ot0tot/OpenOSD-X/doc/BreakoutboardBlockDiagram(Dec15,2025) .pdf

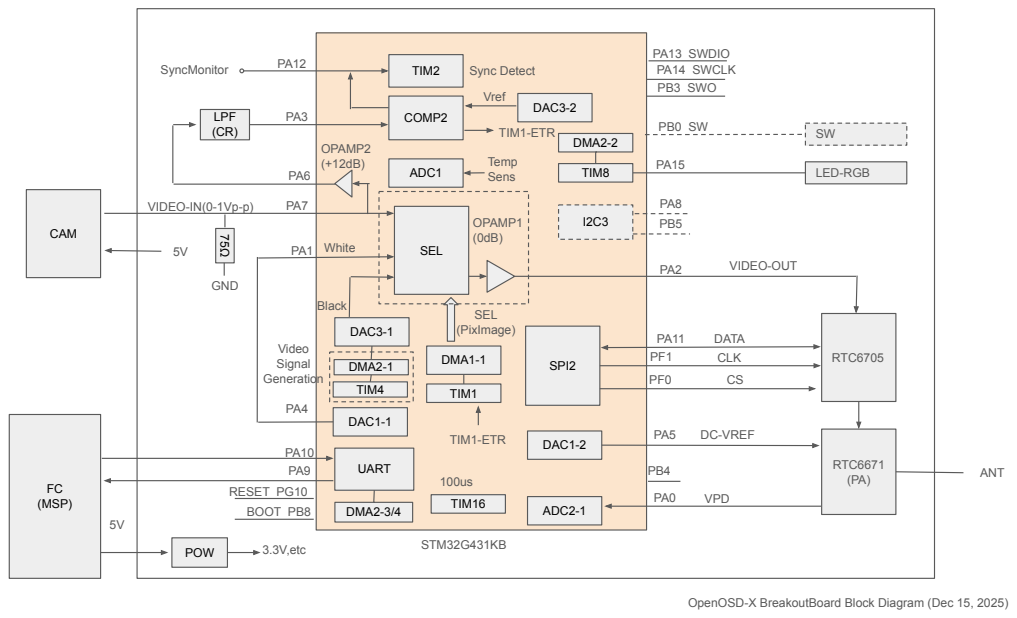
[picture p2: page 1]
COMP2; DAC3-2; Vref; TIM2; SEL; Sync Detect; DAC3-1; DMA1-1; TIM1; DAC1-1; SEL (PixImage); SyncMonitor; TIM4; Black; White; UART; DAC1-2; ADC2-1; SPI2; RTC6705; DATA; CLK; RTC6671 (PA); OPAMP1 (0dB); VIDEO-OUT; VIDEO-IN(0-1Vp-p); ANT; POW; CAM; STM32G431KB; FC (MSP); 3.3V,etc; VPD; DC-VREF; ADC1; PA13 SWDIO PA14 SWCLK; PB3 SWO; LED-RGB; RESET PG10; DMA2-1; Video Signal Generation; GND; LPF; OPAMP2 (+12dB); TIM1-ETR; TIM8; DMA2-2; BOOT PB8; TIM16; DMA2-3/4; Temp Sens

OpenOSD-X BreakoutBoard Block Diagram (Dec 15, 2025)

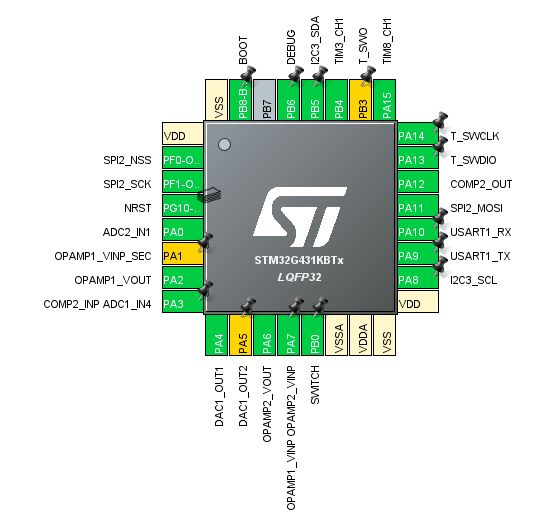
[picture p3: figure]

### NOTE

### Internal Oscillator Since the error is 1%, the rightmost character varies by about half a

character to the left and right, but this is acceptable.

### Input video signal

supports only 0–1 Vp-p.

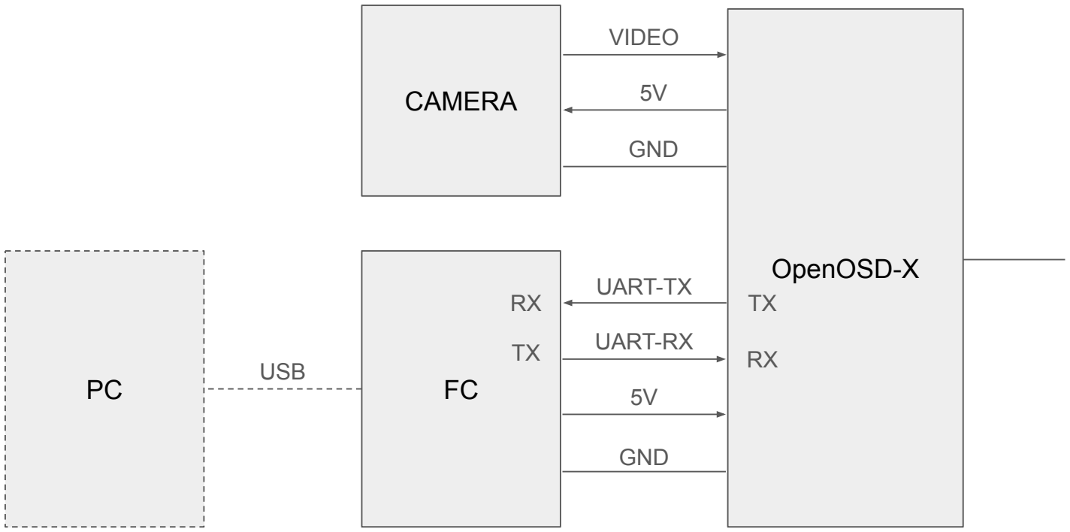
[picture p4: figure]
CAMERA; OpenOSD-X; VIDEO; GND; UART-TX; UART-RX; USB

## ANTENNA
