ot0tot/OpenOSD-X/doc/043_OpenOSD-X_REFERENCE.pdf

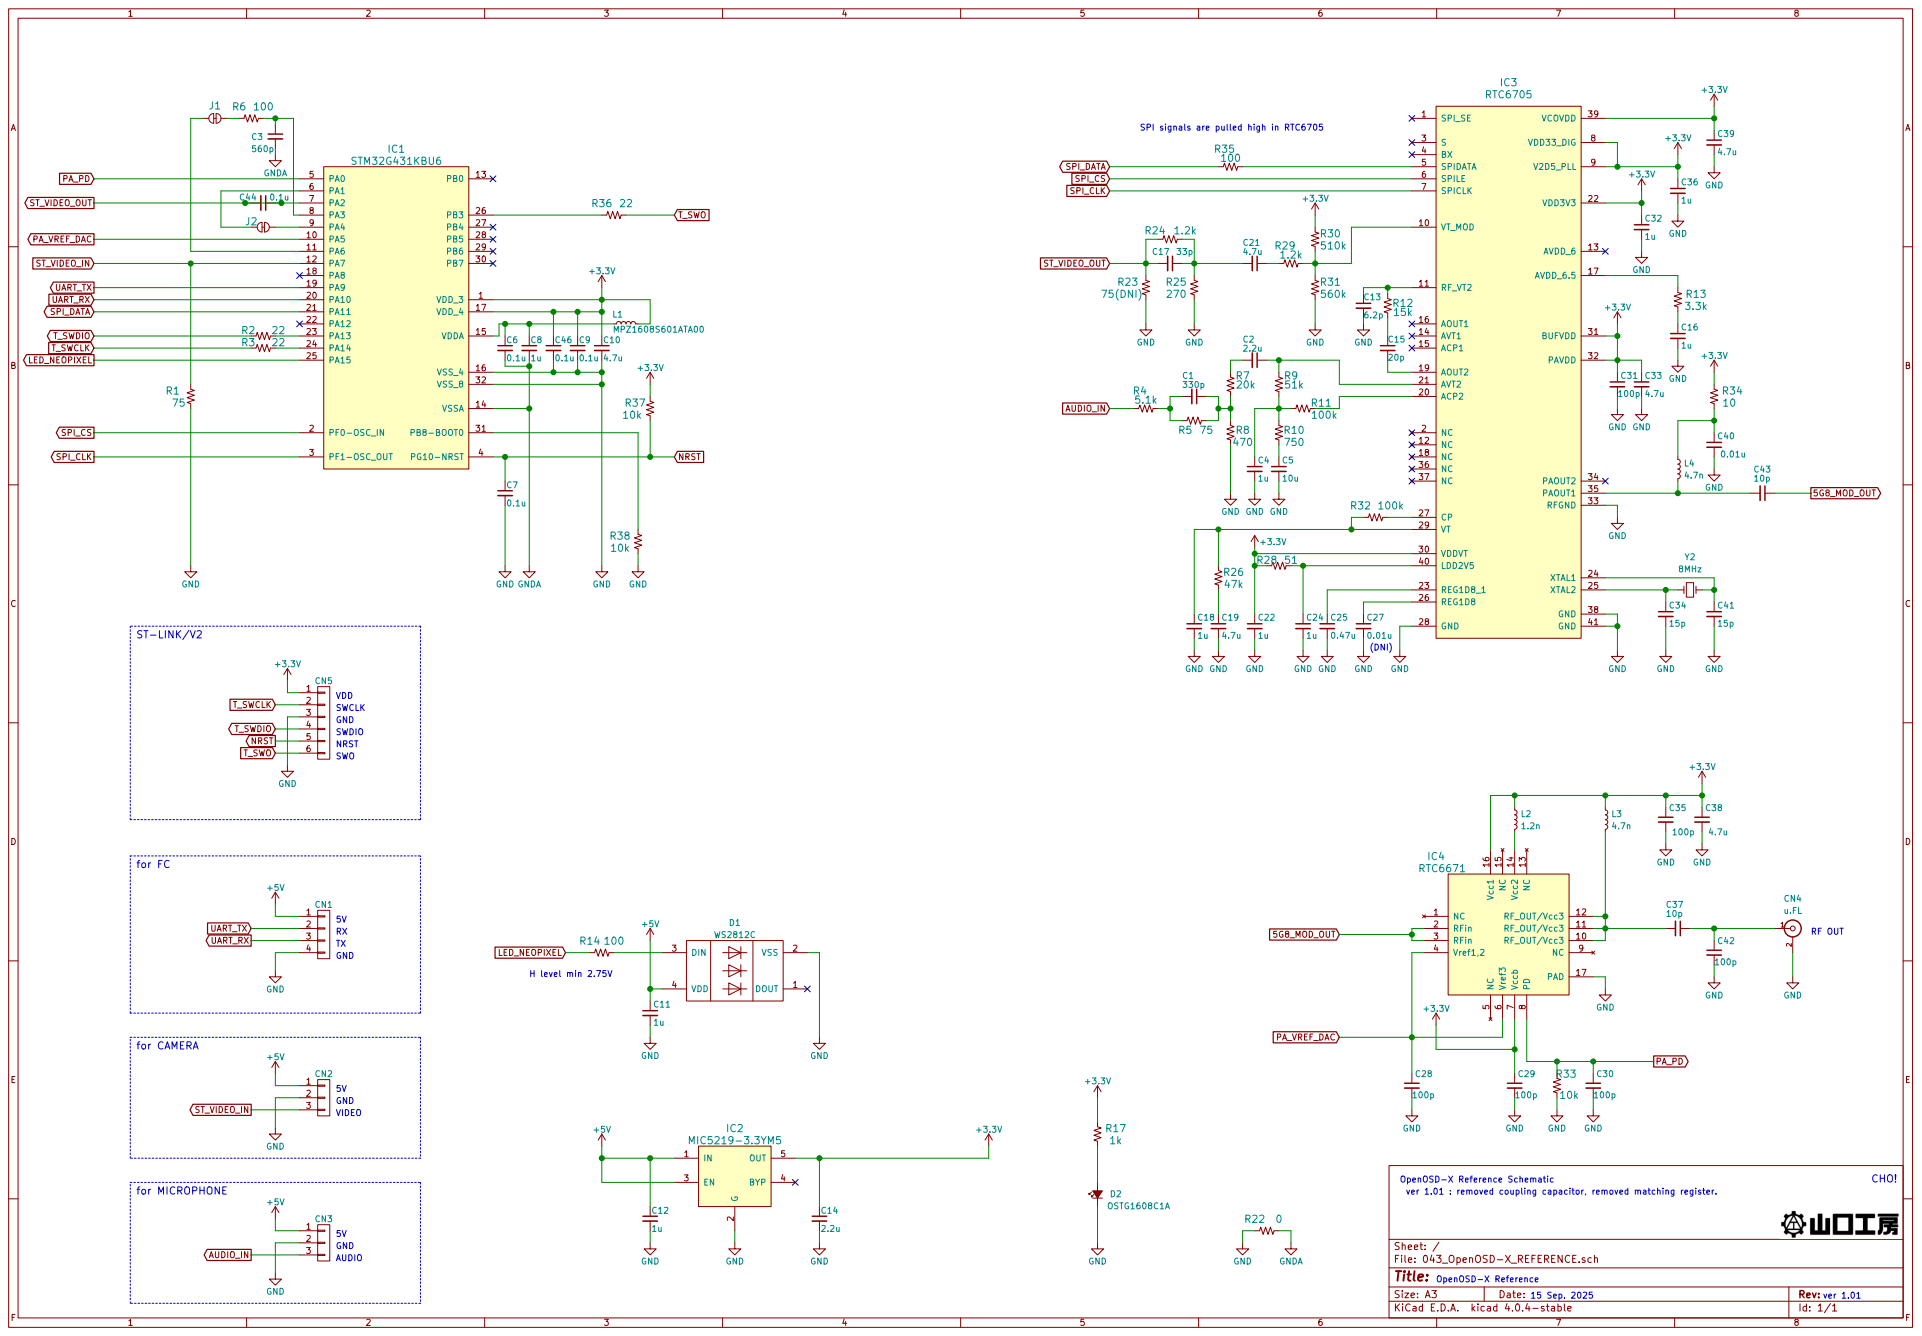
[picture p6: page 1]

SPI signals are pulled high in RTC6705

8 NC 9 RF_OUT/Vcc3 10 RF_OUT/Vcc3 11 RF_OUT/Vcc3 12 NC 13 Vcc2 14 NC 15 Vcc1 16 PAD 17

u.FL GND OpenOSD-X Reference

ver 1.01 : removed coupling capacitor, removed matching register.
