ot0tot/OpenOSD-X/Src/Core/Src/main.c

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
/* Includes ------------------------------------------------------------------*/
#include "stm32g4xx.h"

#include "main.h"
#include "sys_timer.h"
#include "msp.h"
#include "mspvtx.h"
#include "led.h"
#include "char_canvas.h"
#include "font.h"
#include "cli.h"
#include "log.h"
#include "rtc6705.h"
#include "vtx.h"
#include "temp.h"
#include "uart_dma.h"
#include "videosignal_gen.h"
#include "flash.h"
#include "setting.h"

/* USER CODE BEGIN PD */
#define TICKS_TO_HZ(ticks) ((170000000) / (ticks))
#define DEBUG_DAC2 0
#define DEBUG_VIDEO_STANDARD 0

#define SYNC_COUNT_5MS          148     // 5ms/32us = 156 count, 156count *0.95 = 148count
#define SYNC_LOST_CONSEC_MAX    10
#define SIGNAL_GEN_COUNT    1000/5  // signal lost detect time : 1sec

/* USER CODE END PD */

ADC_HandleTypeDef hadc1;
ADC_HandleTypeDef hadc2;

COMP_HandleTypeDef hcomp2;

DAC_HandleTypeDef hdac1;
DAC_HandleTypeDef hdac3;
DMA_HandleTypeDef hdma_dac3_ch1;

OPAMP_HandleTypeDef hopamp1;
OPAMP_HandleTypeDef hopamp2;

SPI_HandleTypeDef hspi2;

TIM_HandleTypeDef htim1;
TIM_HandleTypeDef htim2;
TIM_HandleTypeDef htim3;
TIM_HandleTypeDef htim4;
TIM_HandleTypeDef htim16;
DMA_HandleTypeDef hdma_tim1_up;
DMA_HandleTypeDef hdma_tim8_up;

UART_HandleTypeDef huart1;
DMA_HandleTypeDef hdma_usart1_rx;
DMA_HandleTypeDef hdma_usart1_tx;

void SystemClock_Config(void);
static void MX_GPIO_Init(void);
static void MX_DMA_Init(void);
static void MX_DAC1_Init(void);
static void MX_DAC3_Init(void);
static void MX_OPAMP1_Init(void);
static void MX_TIM1_Init(void);
static void MX_TIM2_Init(void);
static void MX_USART1_UART_Init(void);
static void MX_COMP2_Init(void);
static void MX_SPI2_Init(void);
static void MX_ADC2_Init(void);
static void MX_TIM3_Init(void);
static void MX_OPAMP2_Init(void);
static void MX_ADC1_Init(void);
static void MX_TIM4_Init(void);
static void MX_TIM16_Init(void);
/* USER CODE BEGIN PFP */


#define VIDEO_FORMAT_STR    ((setting()->videoFormat == VIDEO_PAL) ? "PAL" : "NTSC")

typedef enum {
    FRAME_UNKNOWN=0,
    FRAME_EVEN,
    FRAME_ODD,
}FRAME_ODD_EVEN;


typedef enum {
    STATE_LOST = 0,
    STATE_TUNE_PULSE_LEVEL_LOW,
    STATE_TUNE_PULSE_LEVEL_HIGH,
    STATE_VSYNC_WAIT,
    STATE_SYNC,
    STATE_DISABLE,
}STATE;
STATE state = STATE_LOST;

char *state_str[] = {
    "STATE_LOST",
    "STATE_TUNE_PULSE_LEVEL_LOW",
    "STATE_TUNE_PULSE_LEVEL_HIGH",
    "STATE_VSYNC_WAIT",
    "STATE_SYNC",
    "STATE_DISABLE",
};

int32_t canvas_v_offset[]  ={CANVAS_V_OFFSET_NTSC, CANVAS_V_OFFSET_PAL};
int32_t canvas_v[]         ={CANVAS_V_NTSC, CANVAS_V_PAL};

static uint16_t pluse_level_low = 1000;
static uint16_t pluse_level_high = 0;
static uint16_t state_lost_count = 0;

static bool osd_ebable = true;


__attribute__((section (".sram2")))
uint32_t font2selTable[256][4] = {
    {BLK, BLK, BLK, BLK}, {BLK, BLK, BLK, TRS}, {BLK, BLK, BLK, WHI}, {BLK, BLK, BLK, TRS}, {BLK, BLK, TRS, BLK}, {BLK, BLK, TRS, TRS}, {BLK, BLK, TRS, WHI}, {BLK, BLK, TRS, TRS}, // 0x00
    {BLK, BLK, WHI, BLK}, {BLK, BLK, WHI, TRS}, {BLK, BLK, WHI, WHI}, {BLK, BLK, WHI, TRS}, {BLK, BLK, TRS, BLK}, {BLK, BLK, TRS, TRS}, {BLK, BLK, TRS, WHI}, {BLK, BLK, TRS, TRS}, // 0x08
    {BLK, TRS, BLK, BLK}, {BLK, TRS, BLK, TRS}, {BLK, TRS, BLK, WHI}, {BLK, TRS, BLK, TRS}, {BLK, TRS, TRS, BLK}, {BLK, TRS, TRS, TRS}, {BLK, TRS, TRS, WHI}, {BLK, TRS, TRS, TRS}, // 0x10
    {BLK, TRS, WHI, BLK}, {BLK, TRS, WHI, TRS}, {BLK, TRS, WHI, WHI}, {BLK, TRS, WHI, TRS}, {BLK, TRS, TRS, BLK}, {BLK, TRS, TRS, TRS}, {BLK, TRS, TRS, WHI}, {BLK, TRS, TRS, TRS}, // 0x18
    {BLK, WHI, BLK, BLK}, {BLK, WHI, BLK, TRS}, {BLK, WHI, BLK, WHI}, {BLK, WHI, BLK, TRS}, {BLK, WHI, TRS, BLK}, {BLK, WHI, TRS, TRS}, {BLK, WHI, TRS, WHI}, {BLK, WHI, TRS, TRS}, // 0x20
    {BLK, WHI, WHI, BLK}, {BLK, WHI, WHI, TRS}, {BLK, WHI, WHI, WHI}, {BLK, WHI, WHI, TRS}, {BLK, WHI, TRS, BLK}, {BLK, WHI, TRS, TRS}, {BLK, WHI, TRS, WHI}, {BLK, WHI, TRS, TRS}, // 0x28
    {BLK, TRS, BLK, BLK}, {BLK, TRS, BLK, TRS}, {BLK, TRS, BLK, WHI}, {BLK, TRS, BLK, TRS}, {BLK, TRS, TRS, BLK}, {BLK, TRS, TRS, TRS}, {BLK, TRS, TRS, WHI}, {BLK, TRS, TRS, TRS}, // 0x30
    {BLK, TRS, WHI, BLK}, {BLK, TRS, WHI, TRS}, {BLK, TRS, WHI, WHI}, {BLK, TRS, WHI, TRS}, {BLK, TRS, TRS, BLK}, {BLK, TRS, TRS, TRS}, {BLK, TRS, TRS, WHI}, {BLK, TRS, TRS, TRS}, // 0x38
    {TRS, BLK, BLK, BLK}, {TRS, BLK, BLK, TRS}, {TRS, BLK, BLK, WHI}, {TRS, BLK, BLK, TRS}, {TRS, BLK, TRS, BLK}, {TRS, BLK, TRS, TRS}, {TRS, BLK, TRS, WHI}, {TRS, BLK, TRS, TRS}, // 0x40
    {TRS, BLK, WHI, BLK}, {TRS, BLK, WHI, TRS}, {TRS, BLK, WHI, WHI}, {TRS, BLK, WHI, TRS}, {TRS, BLK, TRS, BLK}, {TRS, BLK, TRS, TRS}, {TRS, BLK, TRS, WHI}, {TRS, BLK, TRS, TRS}, // 0x48
    {TRS, TRS, BLK, BLK}, {TRS, TRS, BLK, TRS}, {TRS, TRS, BLK, WHI}, {TRS, TRS, BLK, TRS}, {TRS, TRS, TRS, BLK}, {TRS, TRS, TRS, TRS}, {TRS, TRS, TRS, WHI}, {TRS, TRS, TRS, TRS}, // 0x50
    {TRS, TRS, WHI, BLK}, {TRS, TRS, WHI, TRS}, {TRS, TRS, WHI, WHI}, {TRS, TRS, WHI, TRS}, {TRS, TRS, TRS, BLK}, {TRS, TRS, TRS, TRS}, {TRS, TRS, TRS, WHI}, {TRS, TRS, TRS, TRS}, // 0x58
    {TRS, WHI, BLK, BLK}, {TRS, WHI, BLK, TRS}, {TRS, WHI, BLK, WHI}, {TRS, WHI, BLK, TRS}, {TRS, WHI, TRS, BLK}, {TRS, WHI, TRS, TRS}, {TRS, WHI, TRS, WHI}, {TRS, WHI, TRS, TRS}, // 0x60
    {TRS, WHI, WHI, BLK}, {TRS, WHI, WHI, TRS}, {TRS, WHI, WHI, WHI}, {TRS, WHI, WHI, TRS}, {TRS, WHI, TRS, BLK}, {TRS, WHI, TRS, TRS}, {TRS, WHI, TRS, WHI}, {TRS, WHI, TRS, TRS}, // 0x68
    {TRS, TRS, BLK, BLK}, {TRS, TRS, BLK, TRS}, {TRS, TRS, BLK, WHI}, {TRS, TRS, BLK, TRS}, {TRS, TRS, TRS, BLK}, {TRS, TRS, TRS, TRS}, {TRS, TRS, TRS, WHI}, {TRS, TRS, TRS, TRS}, // 0x70
    {TRS, TRS, WHI, BLK}, {TRS, TRS, WHI, TRS}, {TRS, TRS, WHI, WHI}, {TRS, TRS, WHI, TRS}, {TRS, TRS, TRS, BLK}, {TRS, TRS, TRS, TRS}, {TRS, TRS, TRS, WHI}, {TRS, TRS, TRS, TRS}, // 0x78
    {WHI, BLK, BLK, BLK}, {WHI, BLK, BLK, TRS}, {WHI, BLK, BLK, WHI}, {WHI, BLK, BLK, TRS}, {WHI, BLK, TRS, BLK}, {WHI, BLK, TRS, TRS}, {WHI, BLK, TRS, WHI}, {WHI, BLK, TRS, TRS}, // 0x80
    {WHI, BLK, WHI, BLK}, {WHI, BLK, WHI, TRS}, {WHI, BLK, WHI, WHI}, {WHI, BLK, WHI, TRS}, {WHI, BLK, TRS, BLK}, {WHI, BLK, TRS, TRS}, {WHI, BLK, TRS, WHI}, {WHI, BLK, TRS, TRS}, // 0x88
    {WHI, TRS, BLK, BLK}, {WHI, TRS, BLK, TRS}, {WHI, TRS, BLK, WHI}, {WHI, TRS, BLK, TRS}, {WHI, TRS, TRS, BLK}, {WHI, TRS, TRS, TRS}, {WHI, TRS, TRS, WHI}, {WHI, TRS, TRS, TRS}, // 0x90
    {WHI, TRS, WHI, BLK}, {WHI, TRS, WHI, TRS}, {WHI, TRS, WHI, WHI}, {WHI, TRS, WHI, TRS}, {WHI, TRS, TRS, BLK}, {WHI, TRS, TRS, TRS}, {WHI, TRS, TRS, WHI}, {WHI, TRS, TRS, TRS}, // 0x98
    {WHI, WHI, BLK, BLK}, {WHI, WHI, BLK, TRS}, {WHI, WHI, BLK, WHI}, {WHI, WHI, BLK, TRS}, {WHI, WHI, TRS, BLK}, {WHI, WHI, TRS, TRS}, {WHI, WHI, TRS, WHI}, {WHI, WHI, TRS, TRS}, // 0xa0
    {WHI, WHI, WHI, BLK}, {WHI, WHI, WHI, TRS}, {WHI, WHI, WHI, WHI}, {WHI, WHI, WHI, TRS}, {WHI, WHI, TRS, BLK}, {WHI, WHI, TRS, TRS}, {WHI, WHI, TRS, WHI}, {WHI, WHI, TRS, TRS}, // 0xa8
    {WHI, TRS, BLK, BLK}, {WHI, TRS, BLK, TRS}, {WHI, TRS, BLK, WHI}, {WHI, TRS, BLK, TRS}, {WHI, TRS, TRS, BLK}, {WHI, TRS, TRS, TRS}, {WHI, TRS, TRS, WHI}, {WHI, TRS, TRS, TRS}, // 0xb0
    {WHI, TRS, WHI, BLK}, {WHI, TRS, WHI, TRS}, {WHI, TRS, WHI, WHI}, {WHI, TRS, WHI, TRS}, {WHI, TRS, TRS, BLK}, {WHI, TRS, TRS, TRS}, {WHI, TRS, TRS, WHI}, {WHI, TRS, TRS, TRS}, // 0xb8
    {TRS, BLK, BLK, BLK}, {TRS, BLK, BLK, TRS}, {TRS, BLK, BLK, WHI}, {TRS, BLK, BLK, TRS}, {TRS, BLK, TRS, BLK}, {TRS, BLK, TRS, TRS}, {TRS, BLK, TRS, WHI}, {TRS, BLK, TRS, TRS}, // 0xc0
    {TRS, BLK, WHI, BLK}, {TRS, BLK, WHI, TRS}, {TRS, BLK, WHI, WHI}, {TRS, BLK, WHI, TRS}, {TRS, BLK, TRS, BLK}, {TRS, BLK, TRS, TRS}, {TRS, BLK, TRS, WHI}, {TRS, BLK, TRS, TRS}, // 0xc8
    {TRS, TRS, BLK, BLK}, {TRS, TRS, BLK, TRS}, {TRS, TRS, BLK, WHI}, {TRS, TRS, BLK, TRS}, {TRS, TRS, TRS, BLK}, {TRS, TRS, TRS, TRS}, {TRS, TRS, TRS, WHI}, {TRS, TRS, TRS, TRS}, // 0xd0
    {TRS, TRS, WHI, BLK}, {TRS, TRS, WHI, TRS}, {TRS, TRS, WHI, WHI}, {TRS, TRS, WHI, TRS}, {TRS, TRS, TRS, BLK}, {TRS, TRS, TRS, TRS}, {TRS, TRS, TRS, WHI}, {TRS, TRS, TRS, TRS}, // 0xd8
    {TRS, WHI, BLK, BLK}, {TRS, WHI, BLK, TRS}, {TRS, WHI, BLK, WHI}, {TRS, WHI, BLK, TRS}, {TRS, WHI, TRS, BLK}, {TRS, WHI, TRS, TRS}, {TRS, WHI, TRS, WHI}, {TRS, WHI, TRS, TRS}, // 0xe0
    {TRS, WHI, WHI, BLK}, {TRS, WHI, WHI, TRS}, {TRS, WHI, WHI, WHI}, {TRS, WHI, WHI, TRS}, {TRS, WHI, TRS, BLK}, {TRS, WHI, TRS, TRS}, {TRS, WHI, TRS, WHI}, {TRS, WHI, TRS, TRS}, // 0xe8
    {TRS, TRS, BLK, BLK}, {TRS, TRS, BLK, TRS}, {TRS, TRS, BLK, WHI}, {TRS, TRS, BLK, TRS}, {TRS, TRS, TRS, BLK}, {TRS, TRS, TRS, TRS}, {TRS, TRS, TRS, WHI}, {TRS, TRS, TRS, TRS}, // 0xf0
    {TRS, TRS, WHI, BLK}, {TRS, TRS, WHI, TRS}, {TRS, TRS, WHI, WHI}, {TRS, TRS, WHI, TRS}, {TRS, TRS, TRS, BLK}, {TRS, TRS, TRS, TRS}, {TRS, TRS, TRS, WHI}, {TRS, TRS, TRS, TRS}  // 0xf8
};




//uint32_t dataBuffer[2][512] __attribute__((aligned(4))) = {0};
uint32_t dataBuffer[2][CANVAS_H+16] __attribute__((aligned(4))) = {0};

void osd_dma(DETECT_SYNC detect_sync);
void sync_detect(DETECT_SYNC detect_sync);
/* USER CODE END PFP */


/* USER CODE BEGIN 0 */
void rebootDfu(void)
{
    LL_APB1_GRP1_EnableClock(LL_APB1_GRP1_PERIPH_PWR);
    LL_PWR_EnableBkUpAccess();
    LL_APB1_GRP1_EnableClock(LL_APB1_GRP1_PERIPH_RTCAPB);
    LL_RCC_EnableRTC();
    TAMP->BKP0R = BOOTLOADER_DFU_MAGIC;
    __disable_irq(); 
    NVIC_SystemReset();
}

int __io_putchar(uint8_t ch) {
    return ITM_SendChar(ch);
}

void osd_enable(uint8_t en)
{
    if (en){
        state = STATE_LOST;
        state_lost_count = 0;
    }else{
        state = STATE_DISABLE;
        videosignal_gen_stop();
    }
}

__attribute__((section (".ccmram_code"), optimize("O2")))
void SetLine(register volatile uint32_t *data, register volatile uint8_t *buf, int line)
{
    register volatile uint32_t *fp;
    int linex = line*3;
    for(int ch=0; ch<COLUMN_SIZE; ch++){
        register volatile  uint8_t *fontp = (uint8_t*)&font[*buf++][linex];
        fp = font2selTable[ *fontp ];
        *data++ = *fp++;
        *data++ = *fp++;
        *data++ = *fp++;
        *data++ = *fp++;
        fp = font2selTable[ *(fontp+1) ];
        *data++ = *fp++;
        *data++ = *fp++;
        *data++ = *fp++;
        *data++ = *fp++;
        fp = font2selTable[ *(fontp+2) ];
        *data++ = *fp++;
        *data++ = *fp++;
        *data++ = *fp++;
        *data++ = *fp++;
    }
    *data++ = TRS;      // end
    return;
}

__attribute__((section (".ccmram_code"), optimize("O2")))
void intHsyncFallEdge(void)
{
//    HAL_GPIO_WritePin(DEBUG_GPIO_Port, DEBUG_Pin, GPIO_PIN_SET);

    if (state != STATE_DISABLE){
        volatile uint32_t uwIC1Value = TIM2->CCR1;      // down to down edge
        volatile uint32_t uwIC2Value = TIM2->CCR2;      // down to up edge;

        DETECT_SYNC detect_sync = DETECT_UNKNOWN;

        #define HSYNC_PERIOD_MIN (572*17)   // 63.5*0.9  ntsc:63.5
        #define HSYNC_PERIOD_MAX (704*17)   // 64.0*1.1  pal:64.0
        #define HSYNC_PULSE_MIN (44*17)
        #define HSYNC_PULSE_MAX (50*17)
        #define VSYNC_PULSE_MIN (244*17)
        #define VSYNC_PULSE_MAX (298*17)
        #define EQUIVALENT_PULSE_MIN    (20*17)
        #define EQUIVALENT_PULSE_MAX    (26*17)

        if (    uwIC1Value > HSYNC_PERIOD_MIN && uwIC1Value < HSYNC_PERIOD_MAX &&
                uwIC2Value > HSYNC_PULSE_MIN && uwIC2Value < HSYNC_PULSE_MAX ){
                    detect_sync = DETECT_HSYNC;
        } else if ( uwIC1Value > HSYNC_PERIOD_MIN/2 && uwIC1Value < HSYNC_PERIOD_MAX/2 &&
                    uwIC2Value > EQUIVALENT_PULSE_MIN && uwIC2Value < EQUIVALENT_PULSE_MAX ){
                        detect_sync = DETECT_EQUIVALENT;
        }else if (  uwIC1Value > HSYNC_PERIOD_MIN/2 && uwIC1Value < HSYNC_PERIOD_MAX/2 &&
                    uwIC2Value > VSYNC_PULSE_MIN && uwIC2Value < VSYNC_PULSE_MAX ){
                        detect_sync = DETECT_VSYNC;
        }

        osd_dma(detect_sync);
        sync_detect(detect_sync);
    }

//    HAL_GPIO_WritePin(DEBUG_GPIO_Port, DEBUG_Pin, GPIO_PIN_RESET);
}

uint32_t sync_count = 0;                // for detect sync lost
uint16_t sync_lost_consec = 0;
int32_t equivalent_pulse_count = 0;     // ntsc:odd=6,odd=5
int32_t video_line = 0;
int32_t video_line_last = 0;
FRAME_ODD_EVEN  frame_odd_even = FRAME_UNKNOWN;
__attribute__((section (".ccmram_code"), optimize("O2")))
void sync_detect(DETECT_SYNC detect_sync)
{
    switch(detect_sync){
        case DETECT_HSYNC:
            if (frame_odd_even == FRAME_UNKNOWN){
                if (equivalent_pulse_count & 0x1){
                    if (setting()->videoFormat == VIDEO_NTSC){
                        frame_odd_even = FRAME_ODD;
                        video_line = 1;
                    }else{
                        frame_odd_even = FRAME_EVEN;
                        video_line = 0;
                    }
                }else{
                    if (setting()->videoFormat == VIDEO_NTSC){
                        frame_odd_even = FRAME_EVEN;
                        video_line = 0;
                    }else{
                        frame_odd_even = FRAME_ODD;
                        video_line = 1;
                    }
                }
            }else{
                video_line += 2;
            }
            sync_count += 2;
            break;
        case DETECT_VSYNC:
            sync_count++;
            switch(state){
                case STATE_VSYNC_WAIT:
                    state = STATE_SYNC;
                    break;
                case STATE_SYNC:
                    if (video_line > 0){
                        video_line_last = video_line;
                    }
                    video_line = 0;
                    break;
                default:
                    break;
            }
            equivalent_pulse_count = 0;
            frame_odd_even = FRAME_UNKNOWN;
            break;
        case DETECT_EQUIVALENT:
            equivalent_pulse_count++;
            sync_count++;
            break;
        case DETECT_UNKNOWN:
            break;
    }
}

__attribute__((section (".ccmram_code"), optimize("O2")))
void osd_dma(DETECT_SYNC detect_sync)
{
// static uint32_t vcanvas_count = 0;

    if (detect_sync != DETECT_HSYNC){
        //vcanvas_count = 0;
        return;
    }
    if (!osd_ebable){
        return;
    }
    if (state != STATE_SYNC){
        return;
    }
    if ( video_line == 0 ){
        charCanvasNext();
    }

    int32_t canvas_line = video_line - canvas_v_offset[setting()->videoFormat];

    if ( canvas_line >= 0 && canvas_line < canvas_v[setting()->videoFormat] ){

        // 1. Stop TIM1
        TIM1->CR1 &= ~TIM_CR1_CEN;

        // 2. Disable DMA channel
        DMA1_Channel1->CCR &= ~DMA_CCR_EN;

        // 3. Clear TIM1 update flag
        TIM1->SR &= ~TIM_SR_UIF;

        // 4. Disable TIM1 DMA
        TIM1->DIER &= ~TIM_DIER_UDE;

        // 5. Reset TIM1 counter
        TIM1->CNT = 0;

        // 6. Configure DMA transfer: Mem-to-Periph, High priority, no increment on peripheral, increment memory, 32-bit
        DMA1_Channel1->CCR = DMA_CCR_DIR       // Memory to peripheral
                           | DMA_CCR_PL_1      // High priority
                           | DMA_CCR_MINC      // Memory increment
                           | DMA_CCR_MSIZE_1   // Memory size: word
                           | DMA_CCR_PSIZE_1;  // Peripheral size: word

        // 7. Set DMA addresses: source = dataBuffer, destination = OPAMP1->CSR
        DMA1_Channel1->CPAR = (uint32_t)&OPAMP1->CSR;
        DMA1_Channel1->CMAR = (uint32_t)&dataBuffer[(canvas_line>>1) & 0x1];
        // 8. Set number of words to transfer
        DMA1_Channel1->CNDTR = CANVAS_H + 1;

        // 9. Enable DMA channel
        DMA1_Channel1->CCR |= DMA_CCR_EN;

        // 10. Enable DMA request on TIM1 update event
        TIM1->DIER |= TIM_DIER_UDE;

        // 11. Start TIM1
        TIM1->CR1 |= TIM_CR1_CEN;

        // 12. Advance canvas line counter
        //vcanvas_count++;
    }

    int next_line = canvas_line + 2;

    if ( next_line >= 0 && next_line < canvas_v[setting()->videoFormat] ){
        #ifdef RESOLUTION_HD
            SetLine(&dataBuffer[(next_line>>1) & 0x1][CANVAS_H_OFFSET], (uint8_t*)charCanvasGet(next_line/18), next_line % 18);
        #else
            SetLine(&dataBuffer[(next_line>>1) & 0x1][CANVAS_H_OFFSET], (uint8_t*)charCanvasGet((next_line>>1)/18), (next_line>>1) % 18);
        #endif
    }

}



void sync_proc(void)
{
 static uint32_t state_time = 0;

    uint32_t now = HAL_GetTick();
    if(now - state_time < 5){
        return;
    }
    state_time += 5;

    switch(state){
        case STATE_LOST:
            if (sync_count >= SYNC_COUNT_5MS){
                // sync detect
                videosignal_gen_stop();
                pluse_level_high = pluse_level_low +50;
                pluse_level_low -= 50;
                HAL_DAC_SetValue(&hdac3, DAC_CHANNEL_2, DAC_ALIGN_12B_R, (0xfff*pluse_level_low)/3300);
                state = STATE_TUNE_PULSE_LEVEL_LOW;
                DEBUG_PRINTF("state:STATE_TUNE_PULSE_LEVEL_LOW");
            }else{
                state_lost_count = (state_lost_count < SIGNAL_GEN_COUNT) ? state_lost_count+1 : state_lost_count;
                if (state_lost_count == SIGNAL_GEN_COUNT){
                    state_lost_count = 0xffff;
                    videosignal_gen_start();
                }
                pluse_level_low = (pluse_level_low + 250) % (2500);
                pluse_level_low = (pluse_level_low == 0) ? 250 : pluse_level_low;
                HAL_DAC_SetValue(&hdac3, DAC_CHANNEL_2, DAC_ALIGN_12B_R, (0xfff*pluse_level_low)/3300);
            }
            break;
        case STATE_TUNE_PULSE_LEVEL_LOW:
            if (sync_count < SYNC_COUNT_5MS || pluse_level_low == 0){    // min 0mv
                state = STATE_TUNE_PULSE_LEVEL_HIGH;
                DEBUG_PRINTF("state:STATE_TUNE_PULSE_LEVEL_HIGH");
                HAL_DAC_SetValue(&hdac3, DAC_CHANNEL_2, DAC_ALIGN_12B_R, (0xfff*pluse_level_high)/3300);
            }else{
                pluse_level_low -= 50;
                HAL_DAC_SetValue(&hdac3, DAC_CHANNEL_2, DAC_ALIGN_12B_R, (0xfff*pluse_level_low)/3300);
            }
            break;
        case STATE_TUNE_PULSE_LEVEL_HIGH:
            if (sync_count < SYNC_COUNT_5MS || pluse_level_high == 2500){    // max2500mv
                state = STATE_VSYNC_WAIT;
                DEBUG_PRINTF("state:STATE_VSYNC_WAIT)");
                HAL_DAC_SetValue(&hdac3, DAC_CHANNEL_2, DAC_ALIGN_12B_R, (0xfff * ((pluse_level_high + pluse_level_low)/2))/3300);
                HAL_DAC_SetValue(&hdac3, DAC_CHANNEL_1, DAC_ALIGN_12B_R, (0xfff * ((pluse_level_high/4) + 100)/3300));    // black level -12dB=1/4 +50mv       todo: auto level tune
            }else{
                pluse_level_high += 50;
                HAL_DAC_SetValue(&hdac3, DAC_CHANNEL_2, DAC_ALIGN_12B_R, (0xfff*pluse_level_high)/3300);
            }
            break;
        case STATE_VSYNC_WAIT:
        case STATE_SYNC:
            if (sync_count < SYNC_COUNT_5MS){
                if ( ++sync_lost_consec > SYNC_LOST_CONSEC_MAX){
                    DEBUG_PRINTF("state:STATE_LOST)");
                    state = STATE_LOST;
                    pluse_level_low = 1000;
                    state_lost_count = 0;
                }
            }else{
                sync_lost_consec = 0;
            }
            if (video_line_last != 0){;
                if (video_line > 500 && video_line_last < 510) {        // NTSC (262-10)*2= 504
                    setting()->videoFormat = VIDEO_NTSC;     // ntsc
                } else if (video_line > 600 && video_line < 620) {
                    setting()->videoFormat = VIDEO_PAL;     // pal
                }
            }
            break;
        case STATE_DISABLE:
            HAL_DAC_SetValue(&hdac3, DAC_CHANNEL_2, DAC_ALIGN_12B_R, (0xfff*pluse_level_high)/3300);
            break;
    }
    sync_count = 0;
}



__attribute__((section (".ccmram_code"), optimize("O2")))
bool writeFlashFont(uint16_t addr, uint8_t *data)
{
    enableOSD(false);

    HAL_FLASH_Unlock();
    __HAL_FLASH_CLEAR_FLAG(FLASH_FLAG_OPTVERR);
    if ( (addr & 0x1f) == 0 ){
        // erase
        uint32_t erase_addr = (uint32_t)&font[addr][0];
        DEBUG_PRINTF("erase start 0x%x", erase_addr);
        static FLASH_EraseInitTypeDef EraseInitStruct;
        EraseInitStruct.TypeErase   = FLASH_TYPEERASE_PAGES;
        EraseInitStruct.Page        = GET_FLASH_PAGE(erase_addr);
        EraseInitStruct.NbPages     = 1;
        uint32_t PageError = 0;
        if (HAL_FLASHEx_Erase(&EraseInitStruct, &PageError) != HAL_OK){
            ;
        }
        DEBUG_PRINTF("erase end");
    }
    // write
    for(int x=0; x<FONT_SIZE; x+=8){
        uint64_t wdata = *data++;
        wdata += (uint64_t)(*data++)<<8;
        wdata += (uint64_t)(*data++)<<16;
        wdata += (uint64_t)(*data++)<<24;
        wdata += (uint64_t)(*data++)<<32;
        wdata += (uint64_t)(*data++)<<40;
        wdata += (uint64_t)(*data++)<<48;
        wdata += (uint64_t)(*data++)<<56;

        if (HAL_FLASH_Program(FLASH_TYPEPROGRAM_DOUBLEWORD, (uint32_t)&font[addr][x], wdata) == HAL_OK){
        }
    }
    HAL_FLASH_Lock();

    return true;
}
void enableOSD(bool en)
{
    osd_ebable = en;
}




/* USER CODE END 0 */

/**
  * @brief  The application entry point.
  * @retval int
  */
int main(void)
{

  /* USER CODE BEGIN 1 */ 
    DEBUG_INIT();
    DEBUG_PRINTF("Start");
  /* USER CODE END 1 */

  /* MCU Configuration--------------------------------------------------------*/

  /* Reset of all peripherals, Initializes the Flash interface and the Systick. */
  HAL_Init();

  /* Configure the system clock */
  SystemClock_Config();

  /* Initialize all configured peripherals */
  MX_GPIO_Init();
  MX_DMA_Init();
  MX_DAC1_Init();
  MX_DAC3_Init();
  MX_OPAMP1_Init();
  MX_TIM1_Init();
  MX_TIM2_Init();
  MX_USART1_UART_Init();
  MX_COMP2_Init();
  MX_SPI2_Init();
  MX_ADC2_Init();
  MX_TIM3_Init();
  MX_OPAMP2_Init();
  MX_ADC1_Init();
  MX_TIM4_Init();
  MX_TIM16_Init();
  /* USER CODE BEGIN 2 */

    HAL_TIM_Base_MspInit(&htim16);
    initSysTimer();

    for (int x=0; x<CANVAS_H_OFFSET; x++){
        dataBuffer[0][x] = TRS;
        dataBuffer[1][x] = TRS;
    }
    charCanvasInit();


    HAL_COMP_MspInit(&hcomp2);
    HAL_COMP_Start(&hcomp2);

    HAL_OPAMP_MspInit(&hopamp1);
    HAL_OPAMP_Start(&hopamp1);
    OPAMP1->CSR = TRS;

    HAL_OPAMP_MspInit(&hopamp2);
    HAL_OPAMP_Start(&hopamp2);

    HAL_DAC_Init(&hdac1);
    HAL_DAC_MspInit(&hdac1);
    HAL_DAC_Start(&hdac1, DAC_CHANNEL_1);
    HAL_DAC_SetValue(&hdac1, DAC_CHANNEL_1, DAC_ALIGN_12B_R, (0xfff*1500)/3300);    // WHITE:1.5v (Foxeer OSD is 1.5V)

    HAL_DAC_Init(&hdac3);
    HAL_DAC_MspInit(&hdac3);
    HAL_DAC_Start(&hdac3, DAC_CHANNEL_1);
    HAL_DAC_SetValue(&hdac3, DAC_CHANNEL_1, DAC_ALIGN_12B_R, (0xfff*286)/3300);    // 286mVv

    HAL_DAC_MspInit(&hdac3);
    HAL_DAC_Start(&hdac3, DAC_CHANNEL_2);
    HAL_TIM_Base_MspInit(&htim1);

    HAL_TIM_Base_MspInit(&htim2);
    LL_TIM_CC_EnableChannel(TIM2, LL_TIM_CHANNEL_CH1);
    LL_TIM_CC_EnableChannel(TIM2, LL_TIM_CHANNEL_CH2);
    LL_TIM_EnableIT_CC1(TIM2);
    LL_TIM_EnableCounter(TIM2);

    setting_init();
    uart_init();
    initLed();
    msp_init();
#ifndef TARGET_NOVTX
    initVtx();
    mspVtx_init();
    initTemp();
#endif

#ifdef DEV_MODE
    startCli();
#endif
  /* USER CODE END 2 */

  /* Infinite loop */
  /* USER CODE BEGIN WHILE */
  while (1)
  {
    /* USER CODE END WHILE */

    /* USER CODE BEGIN 3 */
    uint8_t rxdata;
#ifdef  DEV_MODE
    uart_poll();
    if (!uart_read_byte(&rxdata)) {
        dataCli(rxdata);
    }
    static uint32_t diag_time = 100;
    if (diag_time < HAL_GetTick()){
        char buf[35];
        diag_time += 100;
        charCanvasClear();

        sprintf(buf,"%s", "---VIDEO---");
        charCanvasWrite(1,0, (uint8_t*)buf, strlen(buf));
        sprintf(buf,"LINE........%d (%s)", (int)video_line_last, VIDEO_FORMAT_STR);
        charCanvasWrite(2,1, (uint8_t*)buf, strlen(buf));
        sprintf(buf,"SYNC-TH.....%04dMV (%d-%d)", (pluse_level_high+pluse_level_low)/2, pluse_level_low, pluse_level_high);
        charCanvasWrite(3,1, (uint8_t*)buf, strlen(buf));
        sprintf(buf,"%s", "---VTX---");
        charCanvasWrite(4,0, (uint8_t*)buf, strlen(buf));
        sprintf(buf,"FREQ........%04dMHZ", getVtxFreq());
        charCanvasWrite(5,1, (uint8_t*)buf, strlen(buf));
        sprintf(buf,"VPD.........%04dMV", getVpd());
        charCanvasWrite(6,1, (uint8_t*)buf, strlen(buf));
        sprintf(buf,"VPD-TARGET..%04dMV", getVpdTarget());
        charCanvasWrite(7,1, (uint8_t*)buf, strlen(buf));
        sprintf(buf,"VREF........%04dMV", getVref());
        charCanvasWrite(8,1, (uint8_t*)buf, strlen(buf));
        sprintf(buf,"TEMP.........%03ld\xe", getTemp());
        charCanvasWrite(9,1, (uint8_t*)buf, strlen(buf));
        charCanvasDraw();
    }
#else
#ifndef TARGET_NOVTX
    mspUpdate();
#endif
    uart_poll();
    
    int cnt=32;
    while(cnt--){
        if (uart_read_byte(&rxdata)){
            break;
        }
        msp_parse_char(rxdata);
    }
#endif

#if 1
    static LED_STATE led_state = LED_OFF;
    static uint32_t previous_time = 0;

    procSysTimer();
    sync_proc();
#ifndef TARGET_NOVTX
    procTemp();
    procVtx();
#endif

    uint32_t now = HAL_GetTick();
    if (now - previous_time > 1000){
        previous_time = now;
        if (led_state == LED_OFF){
            led_state = LED_GREEN128;
        }else{
            led_state = LED_OFF;
        }
        setting_update();
        setLed(led_state);
        DEBUG_PRINTF("led_state=%d",led_state);

        DEBUG_PRINTF("%s : %s(%d)", state_str[state], VIDEO_FORMAT_STR, video_line_last);
        DEBUG_PRINTF("pluse_level %dmv(%d-%d)",(pluse_level_high+pluse_level_low)/2, pluse_level_high, pluse_level_low);
#ifndef TARGET_NOVTX
        debuglogVtx("main");
#endif
//        DEBUG_PRINTF("IC1=%d IC2=%d", uwIC1Value, uwIC2Value);

    }


#endif
  }
  /* USER CODE END 3 */
}

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
