ot0tot/OpenOSD-X/CubeIDE/openosd-x.ioc

Mcu.UserName=STM32G431KBTx
PA0.Signal=ADC2_IN1
PA1.Signal=OPAMP1_VINP_SEC
PA10.Signal=USART1_RX
PA11.Signal=SPI2_MOSI
PA12.Signal=COMP2_OUT
PA13.GPIO_Label=T_SWDIO
PA13.Signal=SYS_JTMS-SWDIO
PA14.GPIO_Label=T_SWCLK
PA14.Signal=SYS_JTCK-SWCLK
PA15.Signal=S_TIM8_CH1
PA2.Signal=OPAMP1_VOUT
PA3.Signal=SharedAnalog_PA3
PA4.Signal=COMP_DAC11_group
PA5.Signal=COMP_DAC12_group
PA6.Signal=OPAMP2_VOUT
PA7.Signal=SharedAnalog_PA7
PA8.Signal=I2C3_SCL
PA9.Signal=USART1_TX
PB0.GPIO_Label=SWITCH
PB0.Signal=GPIO_Input
PB3.GPIO_Label=T_SWO
PB3.Signal=SYS_JTDO-SWO
PB4.Signal=S_TIM3_CH1
PB5.Signal=I2C3_SDA
PB6.GPIO_Label=DEBUG
PB6.Signal=GPIO_Output
PB8-BOOT0.GPIO_Label=BOOT
PB8-BOOT0.Signal=GPIO_Input
PF0-OSC_IN.GPIO_Label=SPI_CS
PF0-OSC_IN.Signal=GPIO_Output
PF1-OSC_OUT.Signal=SPI2_SCK
PG10-NRST.GPIO_Label=NRST
PG10-NRST.Signal=SharedStack_PG10
