ot0tot/OpenOSD-X/Src/Core/Inc/main.h

#define ROW_SIZE_NTSC 26
#define ROW_SIZE_PAL 32
#define COLUMN_SIZE 45
#define CANVAS_H_R  540
#define CANVAS_H_OFFSET   76       // 4pix(1byte) aligne
#define CANVAS_H_OFFSET_GEN   64       // 4pix(1byte) aligne
#define PIX_PERIOD 14               // period =14+1 =15
#define VIDEO_GEN_LINE_NTSC  720    // 170MHz/15734Hz/15=720 ... mod4=0
#define VIDEO_GEN_LINE_PAL   724    // 170MHz/15625Hz/15=724 ... mod4=0
#define ROW_SIZE_NTSC 13
#define ROW_SIZE_PAL 16
#define COLUMN_SIZE 30
#define CANVAS_H_R  360
#define CANVAS_H_OFFSET   36       // 4pix(1byte) aligne
#define CANVAS_H_OFFSET_GEN   28       // 4pix(1byte) aligne
#define PIX_PERIOD 23               // period=23+1=24
#define VIDEO_GEN_LINE_NTSC  448    // 170MHz/15734Hz/24=450.2= --mod4--> 448
#define VIDEO_GEN_LINE_PAL   452    // 170MHz/15625Hz/24=453.3 --mod4--> 452
#define CANVAS_H        (CANVAS_H_R + CANVAS_H_OFFSET)
#define CANVAS_V_OFFSET_NTSC    32
#define CANVAS_V_OFFSET_PAL     36
#define CANVAS_V_OFFSET_NTSC_GEN    16
#define CANVAS_V_OFFSET_PAL_GEN     16
#define CANVAS_V_NTSC           (234*2)     /* 18pix * 13char */
#define CANVAS_V_PAL            (288*2)     /* 18pix * 16char */
#define ROW_SIZE_MAX 32
#define COLUMN_SIZE_MAX 45
#define FONT_SIZE   64
#define SPI_CS_Pin GPIO_PIN_0
#define SPI_CS_GPIO_Port GPIOF
#define NRST_Pin GPIO_PIN_10
#define NRST_GPIO_Port GPIOG
#define SWITCH_Pin GPIO_PIN_0
#define SWITCH_GPIO_Port GPIOB
#define T_SWDIO_Pin GPIO_PIN_13
#define T_SWDIO_GPIO_Port GPIOA
#define T_SWCLK_Pin GPIO_PIN_14
#define T_SWCLK_GPIO_Port GPIOA
#define T_SWO_Pin GPIO_PIN_3
#define T_SWO_GPIO_Port GPIOB
#define DEBUG_Pin GPIO_PIN_6
#define DEBUG_GPIO_Port GPIOB
#define BOOT_Pin GPIO_PIN_8
#define BOOT_GPIO_Port GPIOB
#define BLK 0x138800ed  // VINP3
#define WHI 0x138800e1  // VINP0
#define TRS 0x138800e9  // VINP2
#define BOOTLOADER_DFU_MAGIC    0x8FA3D62C
