ot0tot/OpenOSD-X/Src/Core/Src/videosignal_gen.c

#include <stdbool.h>
#include <string.h>
#include "stm32g4xx.h"
#include "stm32g4xx_ll_dma.h"
#include "main.h"
#include "char_canvas.h"
#include "setting.h"

typedef void (*videoGenFunc)(uint16_t *buf, uint16_t size, uint16_t line);
void videoGenEpNTSC(uint16_t *buf, uint16_t size, uint16_t line);
void videoGenEpPAL(uint16_t *buf, uint16_t size, uint16_t line);
void videoGenBLK(uint16_t *buf, uint16_t size, uint16_t line);
void videoGenVSYN(uint16_t *buf, uint16_t size, uint16_t line);
void videoGenVSYNEven(uint16_t *buf, uint16_t size, uint16_t line);
void videoGenVSYNOdd(uint16_t *buf, uint16_t size, uint16_t line);
void videoGenHSYN(uint16_t *buf, uint16_t size, uint16_t line);
void videoGen1stData(uint16_t *buf, uint16_t size, uint16_t line);
void videoGen2ndData(uint16_t *buf, uint16_t size, uint16_t line);

int32_t canvas_v_offset_gen[]  ={CANVAS_V_OFFSET_NTSC_GEN, CANVAS_V_OFFSET_PAL_GEN};

#define VG_SYN  0
#define VG_BLK  0x0180
#define VG_GRY  0x0280
#define VG_WHI  0x0400

const videoGenFunc videoGenFuncTable[2][1251] = {
    {
        // ntsc
        videoGenEpNTSC,   videoGenEpNTSC, videoGenEpNTSC, videoGenEpNTSC, videoGenEpNTSC, videoGenEpNTSC,     // 1-6
        videoGenVSYN,     videoGenVSYN,   videoGenVSYN,   videoGenVSYN,   videoGenVSYN,   videoGenVSYNEven,   // 7-12
        videoGenEpNTSC,   videoGenEpNTSC, videoGenEpNTSC, videoGenEpNTSC, videoGenEpNTSC, videoGenEpNTSC,     // 13-18
        videoGenHSYN,     videoGenBLK,    videoGenHSYN,   videoGenBLK,    videoGenHSYN,   videoGenBLK,    videoGenHSYN,   videoGenBLK,    videoGenHSYN,   videoGenBLK,    videoGenHSYN,   videoGenBLK, // 19-30
        videoGenHSYN,     videoGenBLK,    videoGenHSYN,   videoGenBLK,    videoGenHSYN,   videoGenBLK,    videoGenHSYN,   videoGenBLK,    videoGenHSYN,   videoGenBLK,     // 31-40
        videoGen1stData,  videoGen2ndData,videoGen1stData,videoGen2ndData,videoGen1stData,videoGen2ndData,videoGen1stData,videoGen2ndData,videoGen1stData,videoGen2ndData, // 41-50
        videoGen1stData,  videoGen2ndData,videoGen1stData,videoGen2ndData,videoGen1stData,videoGen2ndData,videoGen1stData,videoGen2ndData,videoGen1stData,videoGen2ndData, // 51-60
        videoGen1stData,  videoGen2ndData,videoGen1stData,videoGen2ndData,videoGen1stData,videoGen2ndData,videoGen1stData,videoGen2ndData,videoGen1stData,videoGen2ndData, // 61-70
        videoGen1stData,  videoGen2ndData,videoGen1stData,videoGen2ndData,videoGen1stData,videoGen2ndData,videoGen1stData,videoGen2ndData,videoGen1stData,videoGen2ndData, // 71-80
        videoGen1stData,  videoGen2ndData,videoGen1stData,videoGen2ndData,videoGen1stData,videoGen2ndData,videoGen1stData,videoGen2ndData,videoGen1stData,videoGen2ndData, // 81-90
        videoGen1stData,  videoGen2ndData,videoGen1stData,videoGen2ndData,videoGen1stData,videoGen2ndData,videoGen1stData,videoGen2ndData,videoGen1stData,videoGen2ndData, // 91-100
        videoGen1stData,  videoGen2ndData,videoGen1stData,videoGen2ndData,videoGen1stData,videoGen2ndData,videoGen1stData,videoGen2ndData,videoGen1stData,videoGen2ndData, // 101-110
        videoGen1stData,  videoGen2ndData,videoGen1stData,videoGen2ndData,videoGen1stData,videoGen2ndData,videoGen1stData,videoGen2ndData,videoGen1stData,videoGen2ndData, // 111-120
        videoGen1stData,  videoGen2ndData,videoGen1stData,videoGen2ndData,videoGen1stData,videoGen2ndData,videoGen1stData,videoGen2ndData,videoGen1stData,videoGen2ndData, // 121-130
        videoGen1stData,  videoGen2ndData,videoGen1stData,videoGen2ndData,videoGen1stData,videoGen2ndData,videoGen1stData,videoGen2ndData,videoGen1stData,videoGen2ndData, // 131-140
        videoGen1stData,  videoGen2ndData,videoGen1stData,videoGen2ndData,videoGen1stData,videoGen2ndData,videoGen1stData,videoGen2ndData,videoGen1stData,videoGen2ndData, // 141-150
        videoGen1stData,  videoGen2ndData,videoGen1stData,videoGen2ndData,videoGen1stData,videoGen2ndData,videoGen1stData,videoGen2ndData,videoGen1stData,videoGen2ndData, // 151-160
        videoGen1stData,  videoGen2ndData,videoGen1stData,videoGen2ndData,videoGen1stData,videoGen2ndData,videoGen1stData,videoGen2ndData,videoGen1stData,videoGen2ndData, // 161-170
        videoGen1stData,  videoGen2ndData,videoGen1stData,videoGen2ndData,videoGen1stData,videoGen2ndData,videoGen1stData,videoGen2ndData,videoGen1stData,videoGen2ndData, // 171-180
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
        videoGen1stData,videoGen2ndData,videoGen1stData,videoGen2ndData,videoGen1stData,videoGenEpPAL,  videoGenEpPAL,  videoGenEpPAL,  videoGenEpPAL,  videoGenEpPAL,   // 1241-1250
        NULL
    }
};

//__attribute__((section (".sram2")))
uint32_t dataTableVG[256][2] = {
    {VG_BLK | VG_BLK<<16 , VG_BLK | VG_BLK<<16},   // 0x00
    {VG_BLK | VG_BLK<<16 , VG_BLK | VG_GRY<<16},   // 0x01
    {VG_BLK | VG_BLK<<16 , VG_BLK | VG_WHI<<16},   // 0x02
    {VG_BLK | VG_BLK<<16 , VG_BLK | VG_GRY<<16},   // 0x03
    {VG_BLK | VG_BLK<<16 , VG_GRY | VG_BLK<<16},   // 0x04
    {VG_BLK | VG_BLK<<16 , VG_GRY | VG_GRY<<16},   // 0x05
    {VG_BLK | VG_BLK<<16 , VG_GRY | VG_WHI<<16},   // 0x06
    {VG_BLK | VG_BLK<<16 , VG_GRY | VG_GRY<<16},   // 0x07
    {VG_BLK | VG_BLK<<16 , VG_WHI | VG_BLK<<16},   // 0x08
    {VG_BLK | VG_BLK<<16 , VG_WHI | VG_GRY<<16},   // 0x09
    {VG_BLK | VG_BLK<<16 , VG_WHI | VG_WHI<<16},   // 0x0a
    {VG_BLK | VG_BLK<<16 , VG_WHI | VG_GRY<<16},   // 0x0b
    {VG_BLK | VG_BLK<<16 , VG_GRY | VG_BLK<<16},   // 0x0c
    {VG_BLK | VG_BLK<<16 , VG_GRY | VG_GRY<<16},   // 0x0d
    {VG_BLK | VG_BLK<<16 , VG_GRY | VG_WHI<<16},   // 0x0e
    {VG_BLK | VG_BLK<<16 , VG_GRY | VG_GRY<<16},   // 0x0f
    {VG_BLK | VG_GRY<<16 , VG_BLK | VG_BLK<<16},   // 0x10
    {VG_BLK | VG_GRY<<16 , VG_BLK | VG_GRY<<16},   // 0x11
    {VG_BLK | VG_GRY<<16 , VG_BLK | VG_WHI<<16},   // 0x12
    {VG_BLK | VG_GRY<<16 , VG_BLK | VG_GRY<<16},   // 0x13
    {VG_BLK | VG_GRY<<16 , VG_GRY | VG_BLK<<16},   // 0x14
    {VG_BLK | VG_GRY<<16 , VG_GRY | VG_GRY<<16},   // 0x15
    {VG_BLK | VG_GRY<<16 , VG_GRY | VG_WHI<<16},   // 0x16
    {VG_BLK | VG_GRY<<16 , VG_GRY | VG_GRY<<16},   // 0x17
    {VG_BLK | VG_GRY<<16 , VG_WHI | VG_BLK<<16},   // 0x18
    {VG_BLK | VG_GRY<<16 , VG_WHI | VG_GRY<<16},   // 0x19
    {VG_BLK | VG_GRY<<16 , VG_WHI | VG_WHI<<16},   // 0x1a
    {VG_BLK | VG_GRY<<16 , VG_WHI | VG_GRY<<16},   // 0x1b
    {VG_BLK | VG_GRY<<16 , VG_GRY | VG_BLK<<16},   // 0x1c
    {VG_BLK | VG_GRY<<16 , VG_GRY | VG_GRY<<16},   // 0x1d
    {VG_BLK | VG_GRY<<16 , VG_GRY | VG_WHI<<16},   // 0x1e
    {VG_BLK | VG_GRY<<16 , VG_GRY | VG_GRY<<16},   // 0x1f
    {VG_BLK | VG_WHI<<16 , VG_BLK | VG_BLK<<16},   // 0x20
    {VG_BLK | VG_WHI<<16 , VG_BLK | VG_GRY<<16},   // 0x21
    {VG_BLK | VG_WHI<<16 , VG_BLK | VG_WHI<<16},   // 0x22
    {VG_BLK | VG_WHI<<16 , VG_BLK | VG_GRY<<16},   // 0x23
    {VG_BLK | VG_WHI<<16 , VG_GRY | VG_BLK<<16},   // 0x24
    {VG_BLK | VG_WHI<<16 , VG_GRY | VG_GRY<<16},   // 0x25
    {VG_BLK | VG_WHI<<16 , VG_GRY | VG_WHI<<16},   // 0x26
    {VG_BLK | VG_WHI<<16 , VG_GRY | VG_GRY<<16},   // 0x27
    {VG_BLK | VG_WHI<<16 , VG_WHI | VG_BLK<<16},   // 0x28
    {VG_BLK | VG_WHI<<16 , VG_WHI | VG_GRY<<16},   // 0x29
    {VG_BLK | VG_WHI<<16 , VG_WHI | VG_WHI<<16},   // 0x2a
    {VG_BLK | VG_WHI<<16 , VG_WHI | VG_GRY<<16},   // 0x2b
    {VG_BLK | VG_WHI<<16 , VG_GRY | VG_BLK<<16},   // 0x2c
    {VG_BLK | VG_WHI<<16 , VG_GRY | VG_GRY<<16},   // 0x2d
    {VG_BLK | VG_WHI<<16 , VG_GRY | VG_WHI<<16},   // 0x2e
    {VG_BLK | VG_WHI<<16 , VG_GRY | VG_GRY<<16},   // 0x2f
    {VG_BLK | VG_GRY<<16 , VG_BLK | VG_BLK<<16},   // 0x30
    {VG_BLK | VG_GRY<<16 , VG_BLK | VG_GRY<<16},   // 0x31
    {VG_BLK | VG_GRY<<16 , VG_BLK | VG_WHI<<16},   // 0x32
    {VG_BLK | VG_GRY<<16 , VG_BLK | VG_GRY<<16},   // 0x33
    {VG_BLK | VG_GRY<<16 , VG_GRY | VG_BLK<<16},   // 0x34
    {VG_BLK | VG_GRY<<16 , VG_GRY | VG_GRY<<16},   // 0x35
    {VG_BLK | VG_GRY<<16 , VG_GRY | VG_WHI<<16},   // 0x36
    {VG_BLK | VG_GRY<<16 , VG_GRY | VG_GRY<<16},   // 0x37
    {VG_BLK | VG_GRY<<16 , VG_WHI | VG_BLK<<16},   // 0x38
    {VG_BLK | VG_GRY<<16 , VG_WHI | VG_GRY<<16},   // 0x39
    {VG_BLK | VG_GRY<<16 , VG_WHI | VG_WHI<<16},   // 0x3a
    {VG_BLK | VG_GRY<<16 , VG_WHI | VG_GRY<<16},   // 0x3b
    {VG_BLK | VG_GRY<<16 , VG_GRY | VG_BLK<<16},   // 0x3c
    {VG_BLK | VG_GRY<<16 , VG_GRY | VG_GRY<<16},   // 0x3d
    {VG_BLK | VG_GRY<<16 , VG_GRY | VG_WHI<<16},   // 0x3e
    {VG_BLK | VG_GRY<<16 , VG_GRY | VG_GRY<<16},   // 0x3f
    {VG_GRY | VG_BLK<<16 , VG_BLK | VG_BLK<<16},   // 0x40
    {VG_GRY | VG_BLK<<16 , VG_BLK | VG_GRY<<16},   // 0x41
    {VG_GRY | VG_BLK<<16 , VG_BLK | VG_WHI<<16},   // 0x42
    {VG_GRY | VG_BLK<<16 , VG_BLK | VG_GRY<<16},   // 0x43
    {VG_GRY | VG_BLK<<16 , VG_GRY | VG_BLK<<16},   // 0x44
    {VG_GRY | VG_BLK<<16 , VG_GRY | VG_GRY<<16},   // 0x45
    {VG_GRY | VG_BLK<<16 , VG_GRY | VG_WHI<<16},   // 0x46
    {VG_GRY | VG_BLK<<16 , VG_GRY | VG_GRY<<16},   // 0x47
    {VG_GRY | VG_BLK<<16 , VG_WHI | VG_BLK<<16},   // 0x48
    {VG_GRY | VG_BLK<<16 , VG_WHI | VG_GRY<<16},   // 0x49
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
    {VG_GRY | VG_BLK<<16 , VG_BLK | VG_WHI<<16},   // 0xc2
    {VG_GRY | VG_BLK<<16 , VG_BLK | VG_GRY<<16},   // 0xc3
    {VG_GRY | VG_BLK<<16 , VG_GRY | VG_BLK<<16},   // 0xc4
    {VG_GRY | VG_BLK<<16 , VG_GRY | VG_GRY<<16},   // 0xc5
    {VG_GRY | VG_BLK<<16 , VG_GRY | VG_WHI<<16},   // 0xc6
    {VG_GRY | VG_BLK<<16 , VG_GRY | VG_GRY<<16},   // 0xc7
    {VG_GRY | VG_BLK<<16 , VG_WHI | VG_BLK<<16},   // 0xc8
    {VG_GRY | VG_BLK<<16 , VG_WHI | VG_GRY<<16},   // 0xc9
    {VG_GRY | VG_BLK<<16 , VG_WHI | VG_WHI<<16},   // 0xca
    {VG_GRY | VG_BLK<<16 , VG_WHI | VG_GRY<<16},   // 0xcb
    {VG_GRY | VG_BLK<<16 , VG_GRY | VG_BLK<<16},   // 0xcc
    {VG_GRY | VG_BLK<<16 , VG_GRY | VG_GRY<<16},   // 0xcd
    {VG_GRY | VG_BLK<<16 , VG_GRY | VG_WHI<<16},   // 0xce
    {VG_GRY | VG_BLK<<16 , VG_GRY | VG_GRY<<16},   // 0xcf
    {VG_GRY | VG_GRY<<16 , VG_BLK | VG_BLK<<16},   // 0xd0
    {VG_GRY | VG_GRY<<16 , VG_BLK | VG_GRY<<16},   // 0xd1
    {VG_GRY | VG_GRY<<16 , VG_BLK | VG_WHI<<16},   // 0xd2
    {VG_GRY | VG_GRY<<16 , VG_BLK | VG_GRY<<16},   // 0xd3
    {VG_GRY | VG_GRY<<16 , VG_GRY | VG_BLK<<16},   // 0xd4
    {VG_GRY | VG_GRY<<16 , VG_GRY | VG_GRY<<16},   // 0xd5
    {VG_GRY | VG_GRY<<16 , VG_GRY | VG_WHI<<16},   // 0xd6
    {VG_GRY | VG_GRY<<16 , VG_GRY | VG_GRY<<16},   // 0xd7
    {VG_GRY | VG_GRY<<16 , VG_WHI | VG_BLK<<16},   // 0xd8
    {VG_GRY | VG_GRY<<16 , VG_WHI | VG_GRY<<16},   // 0xd9
    {VG_GRY | VG_GRY<<16 , VG_WHI | VG_WHI<<16},   // 0xda
    {VG_GRY | VG_GRY<<16 , VG_WHI | VG_GRY<<16},   // 0xdb
    {VG_GRY | VG_GRY<<16 , VG_GRY | VG_BLK<<16},   // 0xdc
    {VG_GRY | VG_GRY<<16 , VG_GRY | VG_GRY<<16},   // 0xdd
    {VG_GRY | VG_GRY<<16 , VG_GRY | VG_WHI<<16},   // 0xde
    {VG_GRY | VG_GRY<<16 , VG_GRY | VG_GRY<<16},   // 0xdf
    {VG_GRY | VG_WHI<<16 , VG_BLK | VG_BLK<<16},   // 0xe0
    {VG_GRY | VG_WHI<<16 , VG_BLK | VG_GRY<<16},   // 0xe1
    {VG_GRY | VG_WHI<<16 , VG_BLK | VG_WHI<<16},   // 0xe2
    {VG_GRY | VG_WHI<<16 , VG_BLK | VG_GRY<<16},   // 0xe3
    {VG_GRY | VG_WHI<<16 , VG_GRY | VG_BLK<<16},   // 0xe4
    {VG_GRY | VG_WHI<<16 , VG_GRY | VG_GRY<<16},   // 0xe5
    {VG_GRY | VG_WHI<<16 , VG_GRY | VG_WHI<<16},   // 0xe6
    {VG_GRY | VG_WHI<<16 , VG_GRY | VG_GRY<<16},   // 0xe7
    {VG_GRY | VG_WHI<<16 , VG_WHI | VG_BLK<<16},   // 0xe8
    {VG_GRY | VG_WHI<<16 , VG_WHI | VG_GRY<<16},   // 0xe9
    {VG_GRY | VG_WHI<<16 , VG_WHI | VG_WHI<<16},   // 0xea
    {VG_GRY | VG_WHI<<16 , VG_WHI | VG_GRY<<16},   // 0xeb
    {VG_GRY | VG_WHI<<16 , VG_GRY | VG_BLK<<16},   // 0xec
    {VG_GRY | VG_WHI<<16 , VG_GRY | VG_GRY<<16},   // 0xed
    {VG_GRY | VG_WHI<<16 , VG_GRY | VG_WHI<<16},   // 0xee
    {VG_GRY | VG_WHI<<16 , VG_GRY | VG_GRY<<16},   // 0xef
    {VG_GRY | VG_GRY<<16 , VG_BLK | VG_BLK<<16},   // 0xf0
    {VG_GRY | VG_GRY<<16 , VG_BLK | VG_GRY<<16},   // 0xf1
    {VG_GRY | VG_GRY<<16 , VG_BLK | VG_WHI<<16},   // 0xf2
    {VG_GRY | VG_GRY<<16 , VG_BLK | VG_GRY<<16},   // 0xf3
    {VG_GRY | VG_GRY<<16 , VG_GRY | VG_BLK<<16},   // 0xf4
    {VG_GRY | VG_GRY<<16 , VG_GRY | VG_GRY<<16},   // 0xf5
    {VG_GRY | VG_GRY<<16 , VG_GRY | VG_WHI<<16},   // 0xf6
    {VG_GRY | VG_GRY<<16 , VG_GRY | VG_GRY<<16},   // 0xf7
    {VG_GRY | VG_GRY<<16 , VG_WHI | VG_BLK<<16},   // 0xf8
    {VG_GRY | VG_GRY<<16 , VG_WHI | VG_GRY<<16},   // 0xf9
    {VG_GRY | VG_GRY<<16 , VG_WHI | VG_WHI<<16},   // 0xfa
    {VG_GRY | VG_GRY<<16 , VG_WHI | VG_GRY<<16},   // 0xfb
    {VG_GRY | VG_GRY<<16 , VG_GRY | VG_BLK<<16},   // 0xfc
    {VG_GRY | VG_GRY<<16 , VG_GRY | VG_GRY<<16},   // 0xfd
    {VG_GRY | VG_GRY<<16 , VG_GRY | VG_WHI<<16},   // 0xfe
    {VG_GRY | VG_GRY<<16 , VG_GRY | VG_GRY<<16}    // 0xff
};

uint8_t video_gen_format = 0;    // 0:ntsc 1:pal
uint16_t video_gen_line = 0;    // VIDEO_GEN_LINE_X
uint16_t hpos2nd = 0;
uint32_t vg_vcanvas_count = 0;
uint16_t videoGenCount = 0;

__attribute__((section (".sram2")))
uint16_t videoBuff[VIDEO_GEN_LINE_PAL] __attribute__((aligned(4)));

//void memset16(register volatile uint16_t *dst, register volatile uint16_t data, register volatile uint16_t len16)
//{
//    while(len16--){
//        *dst++ = data;
//    }
//}
__attribute__((section (".ccmram_code")))
void memset16(volatile uint16_t *dst, uint16_t data, uint16_t len16)
{
    __asm__ volatile (
        "1:\n"
        "strh %[data], [%[dst]], #2\n"   // *dst = data; dst += 2;
        "subs %[len], %[len], #1\n"      // len--
        "bne 1b\n"                        // if (len != 0) goto 1;
        : [dst] "+r" (dst), [len] "+r" (len16)
        : [data] "r" (data)
        : "memory"
    );
}

__attribute__((section (".ccmram_code"), optimize("O3")))
void setVideoGenLine(register volatile uint16_t *ldata, uint8_t *buf, int line, register volatile uint16_t hpos, register volatile uint16_t len)
{
    register volatile  uint8_t* fontp;

//    HAL_GPIO_WritePin(GPIOB, GPIO_PIN_5, GPIO_PIN_SET);
    int linex = line*3;

    while( len > 0 ){
        fontp = (uint8_t*)&font[buf[hpos/12]][linex];
        if ((len >= 12) && ((hpos % 12) == 0)){
            register volatile uint32_t *ldata32 = (uint32_t*)ldata;
            register volatile uint32_t *fp;
            fp = (void*)dataTableVG[ *fontp++ ];
            *ldata32++ = *fp++;
            *ldata32++ = *fp++;
            fp = (void*)dataTableVG[ *fontp++ ];
            *ldata32++ = *fp++;
            *ldata32++ = *fp++;
            fp = (void*)dataTableVG[ *fontp ];
            *ldata32++ = *fp++;
            *ldata32++ = *fp++;
            hpos += 12;
            len -= 12;
            ldata += 12;
        }else{
            while( len > 0 ){
                *(uint32_t*)ldata = dataTableVG[ *(uint8_t*)(fontp + ((hpos>>2) % 3) ) ][(hpos>>1) & 0x1];
                hpos +=2;
                len -= 2;
                ldata +=2;
                if ((hpos % 12) == 0){
                    break;
                }
            }
        }
    }
//    HAL_GPIO_WritePin(GPIOB, GPIO_PIN_5, GPIO_PIN_RESET);
    return;
}

// equalization pulse
__attribute__((section (".ccmram_code"), optimize("O2")))
void videoGenEpNTSC(uint16_t *buf, uint16_t size, uint16_t line)
{
    UNUSED(line);

    uint16_t cnt = 0;
    memset16(&buf[cnt], VG_SYN, VIDEO_TIM_NS(2300) );
    cnt += VIDEO_TIM_NS(2300);
    memset16(&buf[cnt], VG_BLK, size - cnt);
}

__attribute__((section (".ccmram_code"), optimize("O2")))
void videoGenEpPAL(uint16_t *buf, uint16_t size, uint16_t line)
{
    UNUSED(line);

    uint16_t cnt = 0;
    memset16(&buf[cnt], VG_SYN, VIDEO_TIM_NS(2350) );
    cnt += VIDEO_TIM_NS(2350);
    memset16(&buf[cnt], VG_BLK, size - cnt);
}

// blank
__attribute__((section (".ccmram_code"), optimize("O2")))
void videoGenBLK(uint16_t *buf, uint16_t size, uint16_t line)
{
    UNUSED(line);
    memset16(buf, VG_BLK, size);
}

// serration pulse
__attribute__((section (".ccmram_code"), optimize("O2")))
void videoGenVSYN(uint16_t *buf, uint16_t size, uint16_t line)
{
    UNUSED(line);
    uint16_t cnt = 0;
    memset16(&buf[cnt], VG_SYN, size - VIDEO_TIM_NS(4700) );
    cnt += size - VIDEO_TIM_NS(4700);
    memset16(&buf[cnt], VG_BLK, size - cnt);
}
__attribute__((section (".ccmram_code"), optimize("O2")))
void videoGenVSYNEven(uint16_t *buf, uint16_t size, uint16_t line)
{
    vg_vcanvas_count = 0;
    videoGenVSYN(buf, size, line);
}
__attribute__((section (".ccmram_code"), optimize("O2")))
void videoGenVSYNOdd(uint16_t *buf, uint16_t size, uint16_t line)
{
    vg_vcanvas_count = 1;
    videoGenVSYN(buf, size, line);
}

// hsync
__attribute__((section (".ccmram_code"), optimize("O2")))
void videoGenHSYN(uint16_t *buf, uint16_t size, uint16_t line)
{
    UNUSED(line);
    uint16_t cnt = 0;
    memset16(&buf[cnt], VG_SYN, VIDEO_TIM_NS(4700) );
    cnt += VIDEO_TIM_NS(4700);
    memset16(&buf[cnt], VG_BLK, size - cnt);
}

// hsync + 1st data
__attribute__((section (".ccmram_code"), optimize("O2")))
void videoGen1stData(uint16_t *buf, uint16_t size, uint16_t line)
{
    UNUSED(line);
    uint16_t cnt = 0;
    memset16(&buf[cnt], VG_SYN, VIDEO_TIM_NS(4700) );
    cnt += VIDEO_TIM_NS(4700);
    memset16(&buf[cnt], VG_BLK, VIDEO_TIM_NS(4700) );
    cnt += VIDEO_TIM_NS(4700);
    uint16_t offset = ( (cnt & 0x1) + (CANVAS_H_OFFSET_GEN>>1) ) & 0xfffe; // 32bit aligned for setVideoGenLine(). uint16_t *buf    @@TODO: adjust offset NTSC/PAL
    memset16(&buf[cnt], VG_GRY, offset);
    cnt += offset;

    hpos2nd = size - cnt;

    int32_t canvas_line = (int32_t)vg_vcanvas_count - canvas_v_offset_gen[setting()->videoFormat];
    if ( canvas_line >= 0 && canvas_line < canvas_v[setting()->videoFormat] ){
#ifdef RESOLUTION_HD
            setVideoGenLine(&buf[cnt], (uint8_t*)charCanvasGet(canvas_line/18), canvas_line % 18, 0, hpos2nd);
#else
            UNUSED(line);
            setVideoGenLine(&buf[cnt], (uint8_t*)charCanvasGet((canvas_line>>1)/18), (canvas_line>>1) % 18, 0, hpos2nd);
#endif
    }else{
        memset16(&buf[cnt], VG_GRY, hpos2nd);
    }
}

// 2nd data + blank
__attribute__((section (".ccmram_code"), optimize("O2")))
void videoGen2ndData(uint16_t *buf, uint16_t size, uint16_t line)
{
    UNUSED(line);
    uint16_t cnt = 0;
    int32_t canvas_line = (int32_t)vg_vcanvas_count - canvas_v_offset_gen[setting()->videoFormat];
    if ( canvas_line >= 0 && canvas_line < canvas_v[setting()->videoFormat] ){
#ifdef RESOLUTION_HD
        setVideoGenLine(&buf[cnt], (uint8_t*)charCanvasGet(canvas_line/18), canvas_line % 18, hpos2nd, CANVAS_H_R - hpos2nd);
#else
        (void)line;
        setVideoGenLine(&buf[cnt], (uint8_t*)charCanvasGet((canvas_line>>1)/18), (canvas_line>>1) % 18, hpos2nd, CANVAS_H_R - hpos2nd);
#endif
        cnt += CANVAS_H_R - hpos2nd;
        memset16(&buf[cnt], VG_GRY, size - cnt);
    }else{
        memset16(&buf[cnt], VG_GRY, size - cnt);
    }
    vg_vcanvas_count += 2;

}
// video gen dac interrupt comp
__attribute__((section (".ccmram_code"), optimize("O2")))
void dmaComp2cp(DMA_HandleTypeDef *_hdma)
{
    UNUSED(_hdma);

//    HAL_GPIO_WritePin(DEBUG_GPIO_Port, DEBUG_Pin, GPIO_PIN_SET);

    (videoGenFuncTable[setting()->videoFormat][videoGenCount])(&videoBuff[video_gen_line/2], video_gen_line/2, vg_vcanvas_count);
    videoGenCount++;
    if (videoGenFuncTable[setting()->videoFormat][videoGenCount] == NULL){
        videoGenCount = 0;
        charCanvasNext();
    }

//    HAL_GPIO_WritePin(DEBUG_GPIO_Port, DEBUG_Pin, GPIO_PIN_RESET);
}

// video gen dac interrupt half
__attribute__((section (".ccmram_code"), optimize("O2")))
void dmaComp2ht(DMA_HandleTypeDef *_hdma)
{
    UNUSED(_hdma);
//    HAL_GPIO_WritePin(DEBUG_GPIO_Port, DEBUG_Pin, GPIO_PIN_SET);
    (videoGenFuncTable[setting()->videoFormat][videoGenCount])(&videoBuff[0], video_gen_line/2, vg_vcanvas_count);
    videoGenCount++;
    if (videoGenFuncTable[setting()->videoFormat][videoGenCount] == NULL){
        videoGenCount = 0;
    }
//    HAL_GPIO_WritePin(DEBUG_GPIO_Port, DEBUG_Pin, GPIO_PIN_RESET);
}


void videosignal_gen_start(void)
{
    video_gen_line = (setting()->videoFormat == VIDEO_PAL) ?  VIDEO_GEN_LINE_PAL : VIDEO_GEN_LINE_NTSC;;

    videoGenBLK(&videoBuff[0], video_gen_line/2, 0);
    videoGenBLK(&videoBuff[video_gen_line/2],video_gen_line/2, 0);
    videoGenCount = 0;

    HAL_TIM_Base_MspInit(&htim4);
    LL_TIM_CC_EnableChannel(TIM4, LL_TIM_CHANNEL_CH2);

    OPAMP1->CSR = BLK;
    LL_DAC_Disable(DAC3, LL_DAC_CHANNEL_1);

    HAL_DMA_RegisterCallback(&hdma_dac3_ch1, HAL_DMA_XFER_HALFCPLT_CB_ID, dmaComp2ht);
    HAL_DMA_RegisterCallback(&hdma_dac3_ch1, HAL_DMA_XFER_CPLT_CB_ID, dmaComp2cp);
    LL_DMA_ConfigTransfer(DMA2,
                                          LL_DMA_CHANNEL_1,
                                          LL_DMA_DIRECTION_MEMORY_TO_PERIPH | LL_DMA_PRIORITY_HIGH | LL_DMA_MODE_CIRCULAR |
                                          LL_DMA_PERIPH_NOINCREMENT | LL_DMA_MEMORY_INCREMENT |
                                          LL_DMA_PDATAALIGN_WORD | LL_DMA_MDATAALIGN_HALFWORD);
    LL_DMA_ConfigAddresses(DMA2,
                                           LL_DMA_CHANNEL_1,
                                           (uint32_t)&videoBuff[0], (uint32_t)&(DAC3->DHR12R1),
                                           LL_DMA_GetDataTransferDirection(DMA2, LL_DMA_CHANNEL_1));
    LL_DMA_SetDataLength(DMA2, LL_DMA_CHANNEL_1, video_gen_line); 

    LL_DMA_EnableIT_HT(DMA2, LL_DMA_CHANNEL_1);
    LL_DMA_EnableIT_TC(DMA2, LL_DMA_CHANNEL_1);
    LL_DAC_EnableDMAReq(DAC3, LL_DAC_CHANNEL_1);
    LL_DAC_EnableTrigger(DAC3, LL_DAC_CHANNEL_1);
    LL_DAC_SetHighFrequencyMode(DAC3, LL_DAC_HIGH_FREQ_MODE_ABOVE_160MHZ);

    LL_DMA_EnableChannel(DMA2, LL_DMA_CHANNEL_1);

    LL_DAC_SetTriggerSource(DAC3, LL_DAC_CHANNEL_1, LL_DAC_TRIG_EXT_TIM4_TRGO);
    LL_DAC_Enable(DAC3, LL_DAC_CHANNEL_1);
    LL_TIM_EnableCounter(TIM4);
}

void videosignal_gen_stop(void)
{
    LL_TIM_DisableCounter(TIM4);
    LL_DAC_SetTriggerSource(DAC3, LL_DAC_CHANNEL_1, LL_DAC_TRIG_SOFTWARE);

    LL_DMA_DisableChannel(DMA2, LL_DMA_CHANNEL_1);
    LL_DAC_DisableTrigger(DAC3, LL_DAC_CHANNEL_1);
    LL_DAC_DisableDMAReq(DAC3, LL_DAC_CHANNEL_1);
    LL_DMA_DisableIT_TC(DMA2, LL_DMA_CHANNEL_1);
    LL_DMA_DisableIT_HT(DMA2, LL_DMA_CHANNEL_1);
}
