ot0tot/OpenOSD-X/scripts/BFinitPassthroughMspreboot_bf46.py

import serial, time, sys, re
import serials_find
import SerialHelper

SCRIPT_DEBUG = 1


class PassthroughEnabled(Exception):
    pass

class PassthroughFailed(Exception):
    pass


def dbg_print(line=''):
    sys.stdout.write(line + '\n')
    sys.stdout.flush()


def bootloader_start(port):
    sys.stdout.flush()
    dbg_print("======== MSP:REBOOT ========")
    dbg_print("  Trying to reboot %s" % (port))

    s = serial.Serial(port=port, baudrate=115200,
        bytesize=8, parity='N', stopbits=1,
        timeout=1, xonxoff=0, rtscts=0)

    rl = SerialHelper.SerialHelper(s, 3., ['CCC', "# "])
    rl.clear()
    data = [0x00] * 9
    data[0] = ord('$')
    data[1] = ord('X')
    data[2] = ord('<')
    data[3] = 0x00
    data[4] = 68       # MSP_REBOOT
    data[5] = 0x00
    data[6] = 0x00
    data[7] = 0x00
    data[8] = 0x06
    BootloaderInitSeq = bytes(data)
    rl.write(BootloaderInitSeq)
    time.sleep(.2)
    s.close()
    dbg_print("======== MSP:REBOOT DONE ========")




def bf_passthrough_init(port, requestedBaudrate=None, half_duplex=False):
    vtx_type = None
    debug =     SCRIPT_DEBUG

    sys.stdout.flush()
    dbg_print("======== PASSTHROUGH INIT ========")
    dbg_print("  Trying to initialize %s" % (port))

    s = serial.Serial(port=port, baudrate=115200,
        bytesize=8, parity='N', stopbits=1,
        timeout=1, xonxoff=0, rtscts=0)

    rl = SerialHelper.SerialHelper(s, 3., ['CCC', "# "])
    rl.clear()
    # Send start command '#'
    dbg_print(" state1")
    #rl.write("#\r\n", half_duplex)
    rl.write("#", half_duplex)
    start = rl.read_line(2.).strip()
    #dbg_print("BF INIT: '%s'" % start.replace("\r", ""))
    if "CCC" in start:
        raise PassthroughEnabled("Passthrough already enabled and bootloader active")
    elif not start or not start.endswith("#"):
        raise PassthroughEnabled("No CLI available. Already in passthrough mode?")

    SerialRXindex = ""

    dbg_print("\nAttempting to detect FC UART configuration...")

    rl.set_delimiters(["\n"])
    rl.clear()
    rl.write("serial\r\n")

    while True:
        line = rl.read_line().strip()
        #print("FC: '%s'" % line)
        if not line or "#" in line:
            break

        if line.startswith("serial UART"):
            if debug:
                dbg_print("  '%s'" % line)
            config = re.search('serial (UART[0-9]+) ([0-9]+) ', line)
            if config:
                if config.group(2) == "2048": # BF https://github.com/betaflight/betaflight/blob/master/docs/Serial.md
                    dbg_print("    ** VTX SA config detected: '%s'" % line)
                    SerialRXindex = config.group(1)
                    vtx_type = "SA"
                elif config.group(2) == "8192":
                    dbg_print("    ** VTX Tramp config detected: '%s'" % line)
                    SerialRXindex = config.group(1)
                    vtx_type = "TRAMP"
                elif config.group(2) == "4096": # INav.  4096 is also FUNCTION_TELEMETRY_IBUS in BF.  So this might cause issues.
                    dbg_print("    ** VTX Tramp config detected: '%s'" % line)
                    SerialRXindex = config.group(1)
                    vtx_type = "TRAMP"
                elif config.group(2) == "131073":
                    dbg_print("    ** VTX MSP config detected: '%s'" % line)
                    SerialRXindex = config.group(1)
                    dbg_print("    SerialRXindex: '%s'" % SerialRXindex)
                    vtx_type = "MSP"
                if not debug:
                    break

    if not SerialRXindex:
        raise PassthroughFailed("!!! VTx Serial not found !!!!\n  Check configuration and try again...")

    cmd = "serialpassthrough %s" % (SerialRXindex)

    dbg_print("Enabling serial passthrough...")
    dbg_print("  CMD: '%s'" % cmd)
    rl.write(cmd + '\n')
    time.sleep(.2)
    s.close()

    dbg_print("======== PASSTHROUGH DONE ========")
    return vtx_type


if __name__ == '__main__':
    try:
        requestedBaudrate = int(sys.argv[1])
    except:
        requestedBaudrate = 115200
    port = serials_find.get_serial_port()

    try:
        bf_passthrough_init(port, requestedBaudrate)
    except PassthroughEnabled as err:
        dbg_print(str(err))

    try:
        bootloader_start(port)
    except PassthroughEnabled as err:
        dbg_print(str(err))
