ot0tot/OpenOSD-X/(commit log)

2025-04-12 Create build.yml
    fix case sensitivity for .ld
2025-04-22 change pin assignment to BreakoutBoard
2025-04-28 G431 Pin assignment updated.
2025-04-28 add RGB-LED (TIM8-CH1)
2025-04-29 add optimaze option
    Optimizations added to functions that require shorter processing times
    [main.c]
2025-04-30 Refactoring of timer processing
2025-05-06 add rtt (Real-Time Transfer)
    Add SEGGER-RTT（Real-Time Transfer）for debug
2025-05-09 add detect video standard, add auto-tune DAC2 voltage
2025-05-28 prototype VTX and PA
2025-08-30 Schematic Diagram and Block Diagram Update
    SchematicDiagram
    Remove the breakout board and add a reference.
    BlockDiagram
    Minor adjustments based on actual conditions
2025-09-16 modified reference schematic
2025-09-20 Drawing bug fixes
    CMS Display Bug Fix
    [char_canvas.c, msp.c]
2025-10-07 Fixed vtx settings save issue
    [flash.c, setting.c]
2025-10-08 Flash Save Area Bug Fix
    [setting.c]
2025-12-13 Add board information and version to the header
2025-12-15 Reduce output during high temperatures
    Utilize the G431's built-in temperature sensor
    Reduce the VTX output when high temperatures are detected
2025-12-16 Temperature display in DEV mode
2025-12-18 Dev Mode OSD Correction
    [main.c]
